NuyGnix6/10-2-myproject/Core/Src/main.c

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
/* Includes ------------------------------------------------------------------*/
#include "main.h"
#include "cmsis_os.h"
#include "adc.h"
#include "dma.h"
#include "spi.h"
#include "tim.h"
#include "usart.h"
#include "gpio.h"

/* USER CODE BEGIN Includes */
#include "FreeRTOS.h"
#include "task.h"
#include "queue.h"

#include <stdio.h>

#include "bsp.h"
#include "DHT11.h"
#include "Light.h"
#include "Buzzer.h"
#include "Key.h"
#include "MyFlash.h"
#include "uart.h"
#include "ESP.h"

#include "AppData.h"
#include "DHT11Task.h"
#include "LightTask.h"
#include "KeyTask.h"
#include "AlarmTask.h"
#include "CMDTask.h"
#include "UartTask.h"
#include "LVGLTask.h"


/* USER CODE END Includes */


void SystemClock_Config(void);
void MX_FREERTOS_Init(void);
/* USER CODE BEGIN 0 */
QueueHandle_t DHT11Queue;
QueueHandle_t LightQueue;

uint8_t page       = 0U;
uint8_t alarm_flag = 0U;
/* USER CODE END 0 */

/**
  * @brief  The application entry point.
  * @retval int
  */
int main(void)
{

  /* MCU Configuration--------------------------------------------------------*/

  /* Reset of all peripherals, Initializes the Flash interface and the Systick. */
  HAL_Init();

  /* Configure the system clock */
  SystemClock_Config();

  /* Initialize all configured peripherals */
  MX_GPIO_Init();
  MX_DMA_Init();
  MX_SPI1_Init();
  MX_TIM2_Init();
  MX_USART1_UART_Init();
  MX_ADC1_Init();
  MX_USART2_UART_Init();
  /* USER CODE BEGIN 2 */
    uint8_t ti, hi, td, hd, ret;

    BSP_Init();          /* 先初始化 DWT，DHT11 的微秒延时靠它 */
    MyFlash_Init();      /* 第一次上电擦 128KB 扇区，卡 1~2 秒，正常 */
    DHT11_Init();
    Light_Init();
    Key_Init();
    UART_Init();         /* 打开串口接收中断，CMDTask 靠它 */
    ESP_Init();
    HAL_TIM_PWM_Start(&htim2, TIM_CHANNEL_2);
    __HAL_TIM_SET_COMPARE(&htim2, TIM_CHANNEL_2, 80);

    /* 采一次数据先垫底，免得任务起来头 2 秒显示 00.0 */
    __disable_irq();
    DHT11_Request();
    ret = DHT11_GetData(&ti, &hi, &td, &hd);
    __enable_irq();
    (void)ret;

    /* 队列 */
    DHT11Queue = xQueueCreate(1, sizeof(DHT11Data_t));
    if(DHT11Queue == NULL) { Error_Handler(); }
    LightQueue = xQueueCreate(1, sizeof(LightData_t));
    if(LightQueue == NULL) { Error_Handler(); }

    /* 任务，优先级照抄 F103 */
    if(xTaskCreate(UartTask, "Uart", 256, NULL, 4, NULL) != pdPASS) { Error_Handler(); }
    if(xTaskCreate(DHT11Task,   "DHT11",   128, NULL, 1, NULL) != pdPASS) { Error_Handler(); }
    if(xTaskCreate(LightTask,   "Light",   128, NULL, 1, NULL) != pdPASS) { Error_Handler(); }
    if(xTaskCreate(CMDTask,     "CMD",     128, NULL, 1, NULL) != pdPASS) { Error_Handler(); }
    if(xTaskCreate(KeyTask,     "Key",     128, NULL, 2, NULL) != pdPASS) { Error_Handler(); }
    if(xTaskCreate(AlarmTask,   "Alarm",   128, NULL, 2, NULL) != pdPASS) { Error_Handler(); }

    /* LVGL 渲染递归深，栈给大一点（3072 字 = 12KB） */
    if(xTaskCreate(LVGLTask,    "LVGL",   3072, NULL, 2, NULL) != pdPASS) { Error_Handler(); }
  /* USER CODE END 2 */

  /* Call init function for freertos objects (in cmsis_os2.c) */
  MX_FREERTOS_Init();

  /* Start scheduler */
  osKernelStart();

  /* We should never get here as control is now taken by the scheduler */

  /* Infinite loop */
  /* USER CODE BEGIN WHILE */
  while (1)
  {
    /* USER CODE END WHILE */

    /* USER CODE BEGIN 3 */
  }
  /* USER CODE END 3 */
}

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
/**
  * @brief  Period elapsed callback in non blocking mode
  * @note   This function is called  when TIM6 interrupt took place, inside
  * HAL_TIM_IRQHandler(). It makes a direct call to HAL_IncTick() to increment
  * a global variable "uwTick" used as application time base.
  * @param  htim : TIM handle
  * @retval None
  */
void HAL_TIM_PeriodElapsedCallback(TIM_HandleTypeDef *htim)
{
  if (htim->Instance == TIM6)
  {
    HAL_IncTick();
  }
}

/**
  * @brief  This function is executed in case of error occurrence.
  * @retval None
  */
void Error_Handler(void)
{
  /* USER CODE BEGIN Error_Handler_Debug */
  /* User can add his own implementation to report the HAL error return state */
  __disable_irq();
  while (1)
  {
  }
  /* USER CODE END Error_Handler_Debug */
}
#ifdef USE_FULL_ASSERT
/**
  * @brief  Reports the name of the source file and the source line number
  *         where the assert_param error has occurred.
  * @param  file: pointer to the source file name
  * @param  line: assert_param error line source number
  * @retval None
  */
void assert_failed(uint8_t *file, uint32_t line)
{
  /* USER CODE BEGIN 6 */
  /* User can add his own implementation to report the file name and line number,
     ex: printf("Wrong parameters value: file %s on line %d\r\n", file, line) */
  /* USER CODE END 6 */
}
#endif /* USE_FULL_ASSERT */
