NuyGnix6/10-2-myproject/10-2 myproject.ioc

Mcu.UserName=STM32F407VGTx
PA0-WKUP.Signal=ADCx_IN0
PA1.Signal=S_TIM2_CH2
PA10.Signal=USART1_RX
PA13.Signal=SYS_JTMS-SWDIO
PA14.Signal=SYS_JTCK-SWCLK
PA2.Signal=USART2_TX
PA3.Signal=USART2_RX
PA4.GPIO_Label=LCD_CS
PA4.Signal=GPIO_Output
PA5.Signal=SPI1_SCK
PA7.Signal=SPI1_MOSI
PA9.Signal=USART1_TX
PB0.GPIO_Label=LCD_DC
PB0.Signal=GPIO_Output
PB1.GPIO_Label=LCD_RST
PB1.Signal=GPIO_Output
PB12.GPIO_Label=DHT11
PB12.Signal=GPIO_Output
PB13.GPIO_Label=Buzzer
PB13.Signal=GPIO_Output
PB14.GPIO_Label=Key_Set
PB14.Signal=GPIO_Input
PB15.GPIO_Label=Key_Down
PB15.Signal=GPIO_Input
PC0.Signal=GPIO_Output
PC1.GPIO_Label=T_IRQ
PC1.Signal=GPIO_Input
PC2.GPIO_Label=T_CLK
PC2.Signal=GPIO_Output
PC3.GPIO_Label=T_SDI
PC3.Signal=GPIO_Output
PC4.Signal=GPIO_Input
PC6.GPIO_Label=Key_Up
PC6.Signal=GPIO_Input
PH0-OSC_IN.Signal=RCC_OSC_IN
PH1-OSC_OUT.Signal=RCC_OSC_OUT
