NuyGnix6/10-2-myproject/Core/Inc/main.h

#define T_IRQ_Pin GPIO_PIN_1
#define T_IRQ_GPIO_Port GPIOC
#define T_CLK_Pin GPIO_PIN_2
#define T_CLK_GPIO_Port GPIOC
#define T_SDI_Pin GPIO_PIN_3
#define T_SDI_GPIO_Port GPIOC
#define LCD_CS_Pin GPIO_PIN_4
#define LCD_CS_GPIO_Port GPIOA
#define LCD_DC_Pin GPIO_PIN_0
#define LCD_DC_GPIO_Port GPIOB
#define LCD_RST_Pin GPIO_PIN_1
#define LCD_RST_GPIO_Port GPIOB
#define DHT11_Pin GPIO_PIN_12
#define DHT11_GPIO_Port GPIOB
#define Buzzer_Pin GPIO_PIN_13
#define Buzzer_GPIO_Port GPIOB
#define Key_Set_Pin GPIO_PIN_14
#define Key_Set_GPIO_Port GPIOB
#define Key_Down_Pin GPIO_PIN_15
#define Key_Down_GPIO_Port GPIOB
#define Key_Up_Pin GPIO_PIN_6
#define Key_Up_GPIO_Port GPIOC
